brendan-w/midi_cv/README.md

MIDI-to-CV
==========

This is a simple Arduino-based MIDI-to-CV converter module that has a few specializations for WX wind controllers. It has the following outputs:

- Pitch 0-10V
- Gate 0-5V
- Velocity 0-5V
- Breath (CC 2) 0-5V
