brendan-w/midi_cv/midi_cv.pdf

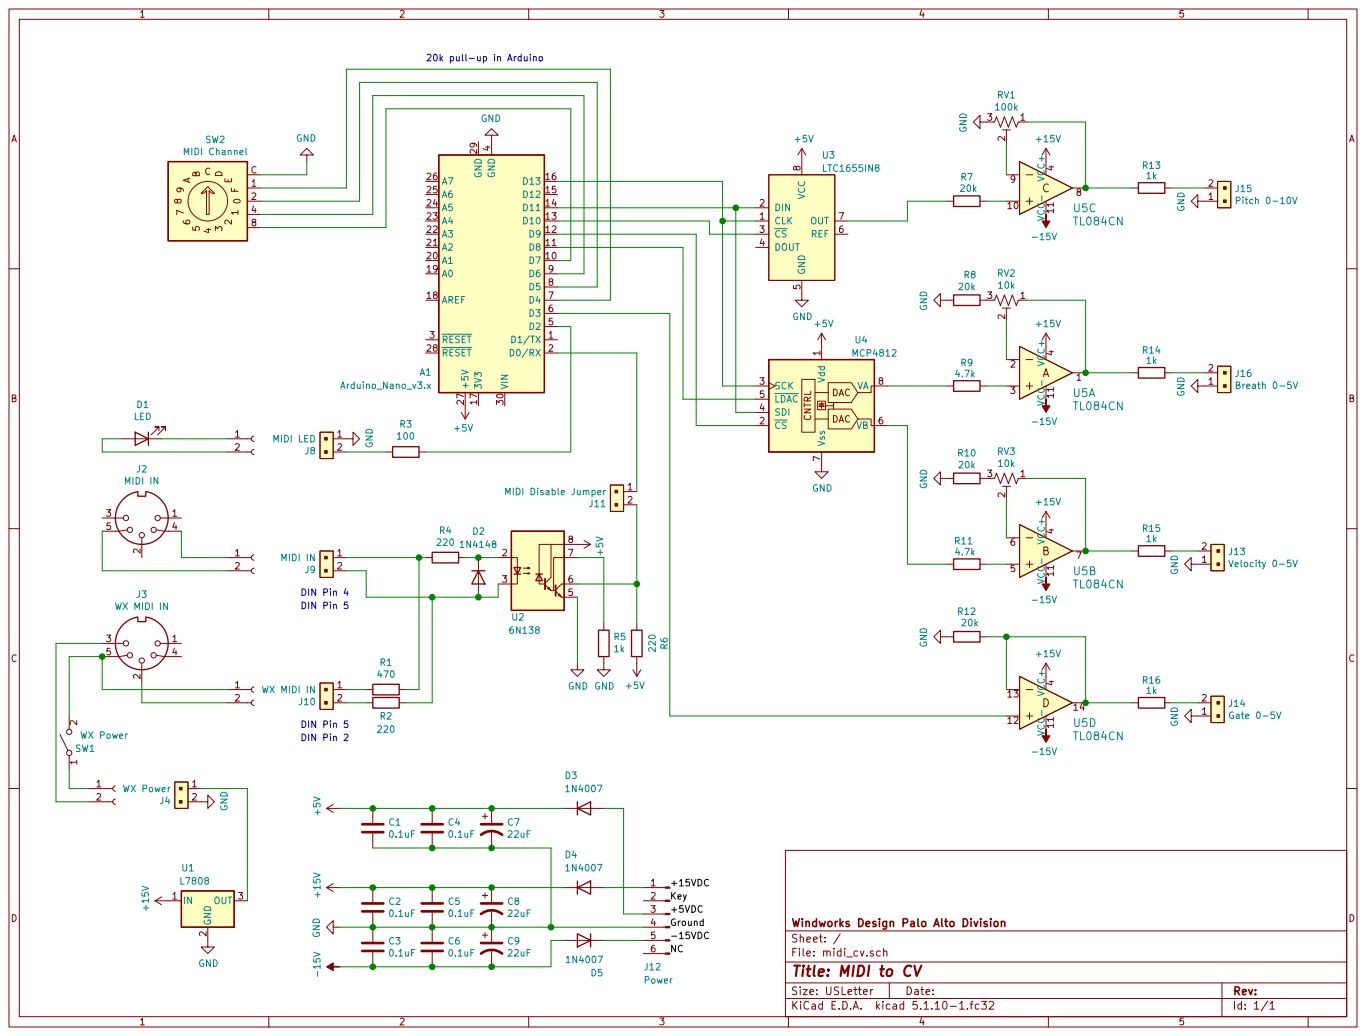
[picture p2: page 1]

20k pull-up in Arduino DIN Pin 2 DIN Pin 5 DIN Pin 5 DIN Pin 4
22uF GND

Id: 1/1 Title: MIDI to CV
