brendan-w/midi_cv/(commit log)

2022-12-10 Added power filtering and WX power
    [midi_cv.sch]
2022-12-11 Got SPI output looking roughly right
2022-12-11 Switched to transfer16() to fix endian
    [midi_cv.ino]
2022-12-11 Added trimmer pots, started working on board layout
    [midi_cv.sch, protoboard_layout.ods]
2022-12-12 Added datasheets and midi library
    [midi_cv.sch, protoboard_layout.ods]
2022-12-14 Added midi channel selector
    [midi_cv.sch]
2022-12-14 Added midi input section
    [midi_cv.sch, protoboard_layout.ods]
2022-12-15 Corrected opamp pinout
    [midi_cv.sch, protoboard_layout.ods]
2022-12-19 Finished PCB
    [midi_cv.sch, protoboard_layout.ods]
2022-12-19 commented out broken curve logic
    [midi_cv.ino]
2022-12-19 cleaned the excel protoboard layout file
    [protoboard_layout.ods]
2022-12-19 ODS to XLSX because customer is on windows
    [protoboard_layout.ods, protoboard_layout.xlsx]
2022-12-28 Fixes and tweaks from WX testing
    - Handle alternate form of NOTE OFF and fixes pitch bend underflows
    - added rolling average filter to breath inputs because the controller is noisy
    - Refactored moving average and added slew down limiter
    - Added settings profiled from the VL1
    - Removed dead zone from breath curve , and ignore active sensing messages
    [midi_cv.ino]
